maciejgrosz/engineer-thesis/engineer-thesis.pdf

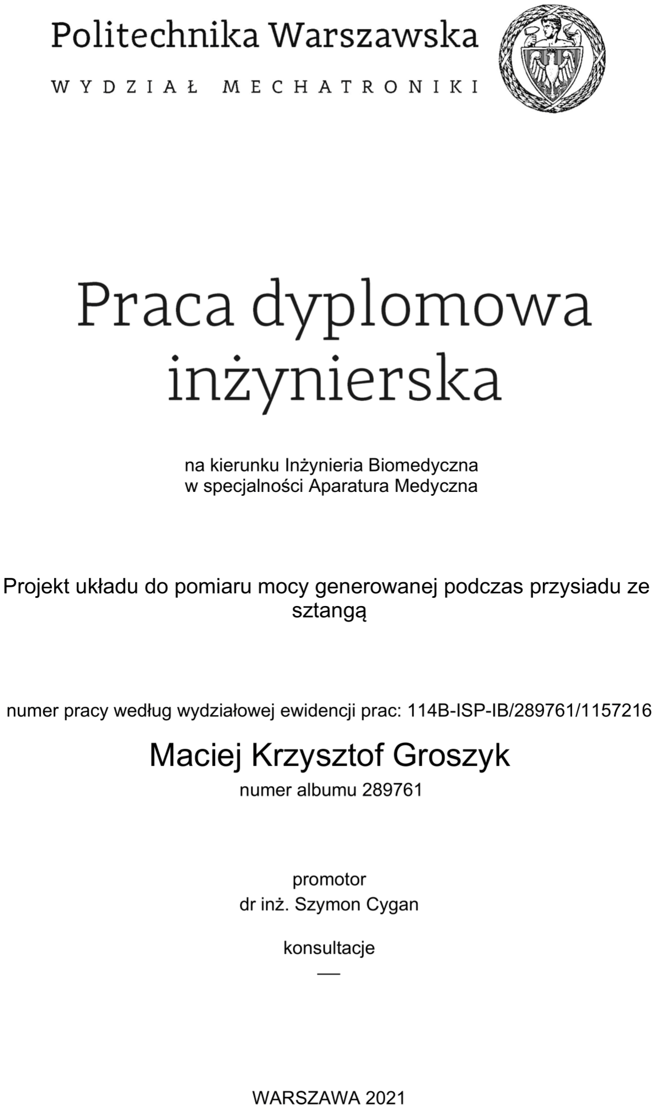
[picture p1: page 1]

1

2

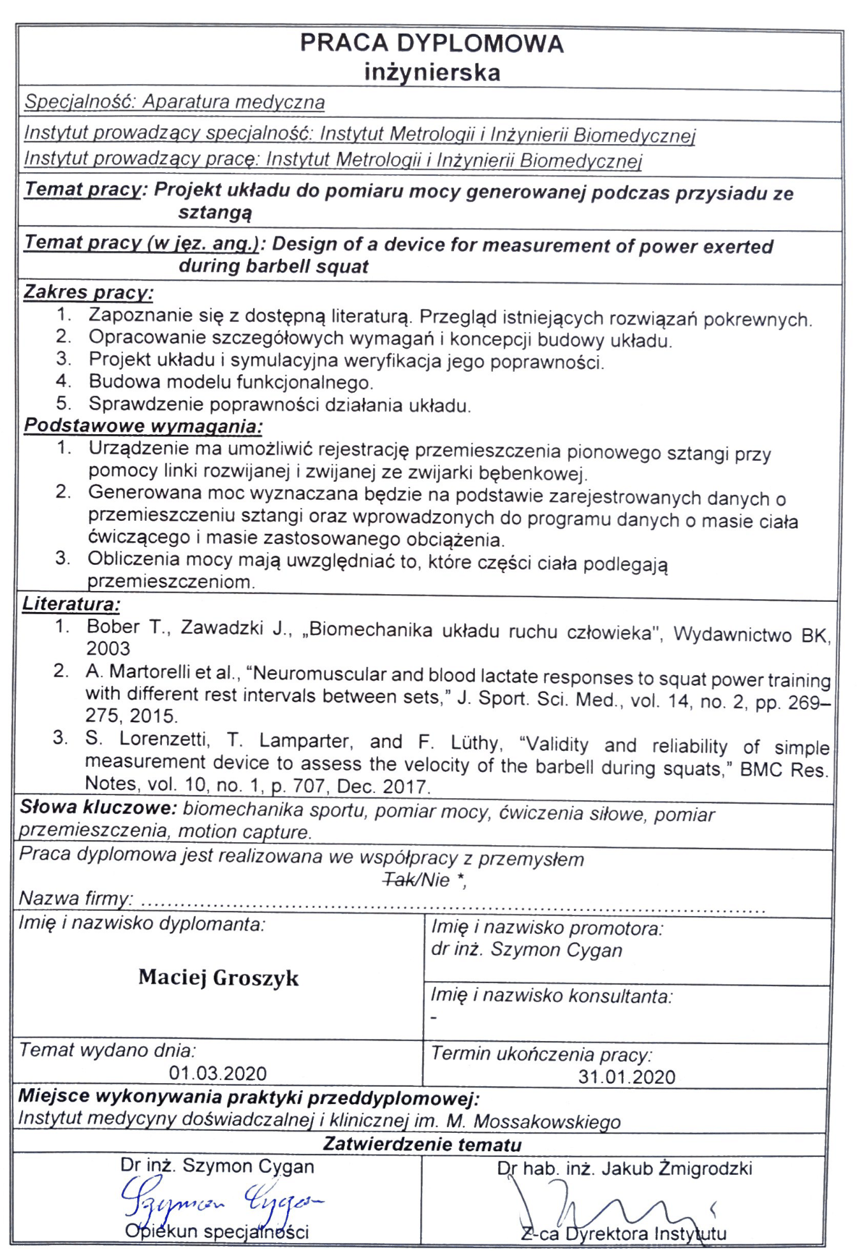
[picture p2: page 3]

3

4

5

Projekt układu do pomiaru mocy generowanej podczas przysiadu ze sztangą

Słowa kluczowe: biomechanika sportu, pomiar mocy, ćwiczenia siłowe, pomiar przemieszczenia

| Streszczenie

Przedmiotem pracy dyplomowej jest projekt układu pomiaru mocy generowanej podczas przysiadu ze sztangą z aplikacją umożliwiającą wizualizację pomiarów w postaci wykresów.

W pierwszym rozdziale został przedstawiony cel pracy oraz założenia jakie należało spełnić podczas projektowania urządzenia i aplikacji. We wstępie został również umieszczony plan pracy, w którym krótko opisano kolejne etapy pracy dyplomowej.

W kolejnym rozdziale przytoczono przykładowe zastosowania urządzenia do pomiaru mocy, a także opis poprawnie wykonanego ćwiczenia tzn. przysiadu ze sztangą, dla którego zaprojektowane są obliczenia i urządzenie. Następnie zaprezentowane zostały przykładowe rozwiązania pomiaru mocy z użyciem enkodera dostępne na rynku.

Główną częścią pracy dyplomowej jest realizacja projektu, której opis stanowi rozdział trzeci. Opisano w nim podstawową zasadę działania urządzenia, a także postawiono wymagania i założenia dotyczące fizycznego modelu konstrukcji. Następnie wymieniono główne elementy wchodzące w skład projektu. Główną częścią urządzenia jest enkoder obrotowy, którego zasada działania została opisana w podrozdziale 3.4.1. Zostały w nim przedstawione różne typy enkoderów, oraz dokładna budowa optycznego enkodera obrotowego, który został wybrany do projektu. W kolejnym punkcie dokładnie opisano użyty model enkodera w projekcie. W następnym etapie pracy uzasadniono wybór mikrokontrolera na platformie Arduino Uno, oraz przedstawiono zdjęcie opisujące płytkę. W kolejnych podrozdziałach została opisana konstrukcja urządzenia oraz sposób działania układu. Wypisane zostały gotowe elementy handlowe oraz przedstawiono cały proces wytwarzania pozostałych elementów do modelu urządzenia. Na końcu został pokazany poprawny schemat podłączenia enkodera do płytki Arduino Uno.

Czwartą częścią pracy są obliczenia wykorzystane w przeliczeniu odczytów z enkodera na moc wytworzoną przez ćwiczącego.

W piątym rozdziale został opisany schemat działania oprogramowania urządzenia. Opisany został zarówno kod zaimplementowany do mikrokontrolera arduino, jak i schemat działania aplikacji komputerowej umożliwiającej łatwe korzystanie z urządzenia przez użytkownika.

W kolejnym rozdziale przedstawiono krok po kroku jak należy poprawnie korzystać z zaprojektowanego układu oraz aplikacji, aby uzyskać prawidłowe wyniki bez zakłóceń i szumów.

W siódmym rozdziale przedstawiono proces kalibracji urządzenia, a także wyniki uzyskane za pomocą rozwiązania komercyjnego oraz pracy dyplomowej Julii Król. A także uzasadniono różnice w uzyskanych rezultatach.

6

Praca została zakończona oceną realizacji urządzenia oraz aplikacji. W końcowym rozdziale zawarto również pomysły na dalszy rozwój urządzenia.

7

Design of a device for measurment of power exerted during barbell squat

Key words: motion capture, sports biomechanics, power measurments, force measurments

Abstract

The subject of this thesis is the design of a system meant to measure the power generated during a barbell squat with an application to visualize the measurements in the form of graphs.

The first chapter purpose of the work and the assumptions that had to be fulfilled during the design of the device and the application are presented. In the introduction there is also a plan of work, which briefly describes the next stages of the thesis.

In the next chapter commercial examples of power measurement device are given, along with a description of a correctly performed exercise, i.e. a squat with a barbell, for which the calculations and the device are designed. Next, examples of power measurement solutions with an encoder available on the market are presented.

The main part of this thesis is the implementation of the project, which is described in the third chapter. The description consists of the basic principle of operation of the device as well as the set of requirements and assumptions for the physical model of the design. Then the main components of the project are listed. The main part of the device is the rotary encoder, whose working principle is described in subsection 3.4.1. The different types of encoders are presented there, as well as the exact construction of the optical rotary encoder that was chosen for the project.

The next section describes in detail the encoder model used in the project. The next section describes in detail the encoder model used in the project, while the next point justifies the choice of the microcontroller on the Arduino Uno platform, and presents a photo describing the board. In the following subsections the construction of the device and the way the circuit works are described. Ready-to-use commercial components are listed and the whole process of manufacturing other components for the device model is presented. At the end , the correct scheme of connecting the encoder to the Arduino Uno board is shown.

The fourth part of the work is the calculations used in converting the readings from the encoder to the power generated by the user.

The fifth section describes the software scheme of the device. The code implemented into the Arduino microcontroller and the operating scheme of the

8

computer application that allows easy use of the device by the user are presented.

The next chapter shows step by step how to use the designed circuit and application correctly to get the right results without noise and interference.

The seventh chapter presents calibration process along with the results obtained using a commercial solution and Julia Król's engineer thesis. The difference in the subsequent results is discussed.

The paper is concluded with the evaluation of the implementation of both the device and the application, as well as possible ideas for further development of the device.

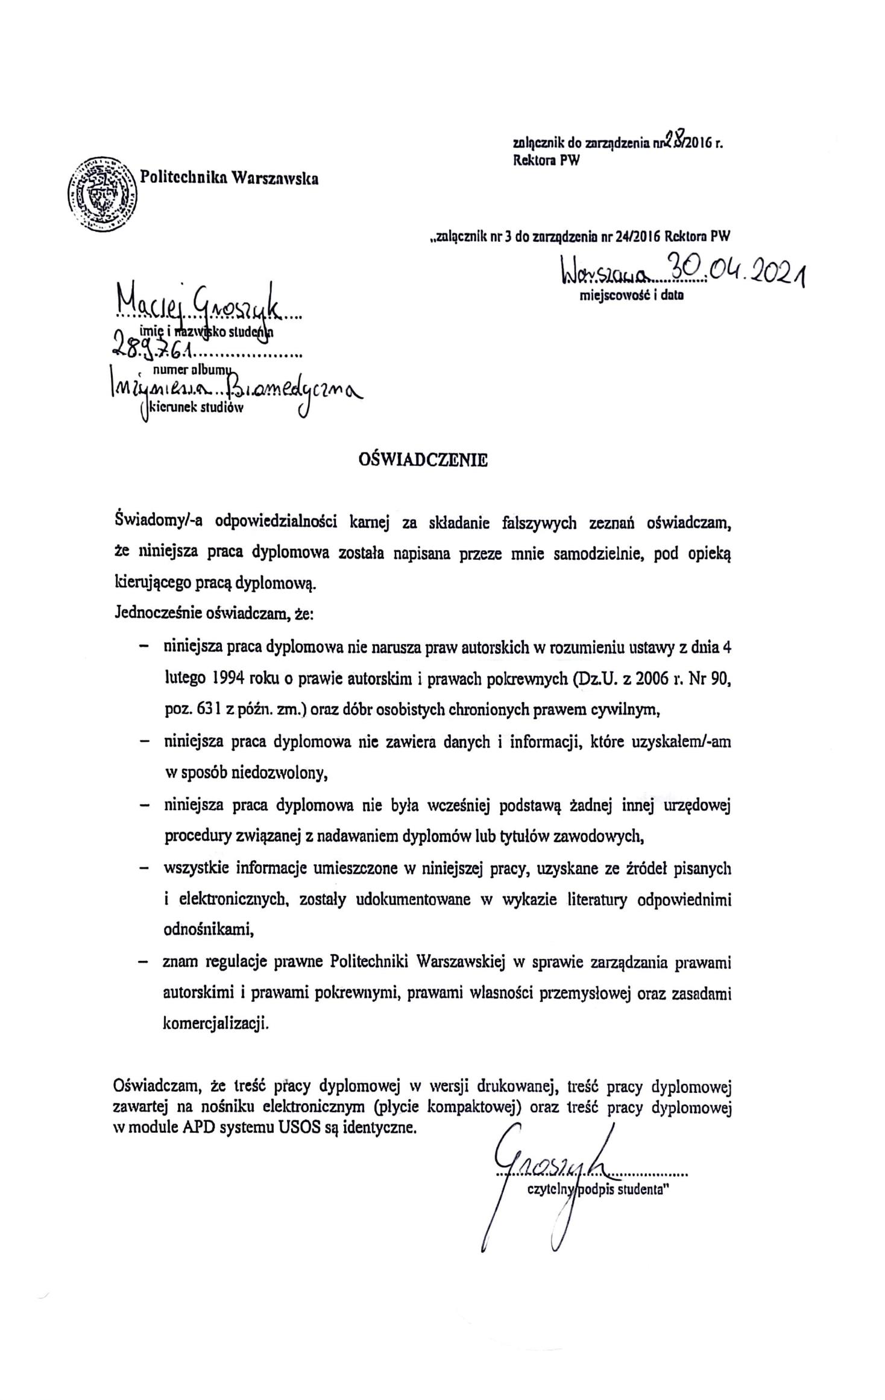
[picture p3: page 9]

9

10

11

Pragnę wyrazić moją wdzięczność trenerowi mgr Michałowi Ficoniowi za umożliwienie mi przeprowadzenia testów wykonanego urządzenia, konsultacje i pomoc w przeprowadzeniu pomiarów, bez których nie miałbym możliwości dodatkowego wzbogacenia swojego urządzenia.

12

13

## Spis treści

14

7.2. Porównanie wyników z urządzeniem komercyjnym firmy MuscleLab ...... 50

15

### 1. Wstęp

### 1.1. Cel i motywacja pracy

Celem pracy jest zaprojektowanie i wykonanie modelu elektronicznego układu do pomiaru mocy generowanej podczas przysiadu ze sztangą. Urządzenie to ma umożliwiać rejestrację przemieszczenia pionowego sztangi podczas ćwiczenia siłowego w postaci przysiadu. Składać się ono będzie z linki mocowanej do sztangi, sprężynowej zwijarki bębenkowej, enkodera obrotowego i układu elektronicznego przetwarzającego sygnał z enkodera do postaci cyfrowej. Następnie sygnał ten będzie przesyłany do komputera, gdzie w oparciu o dane o masie ciała ćwiczącego i masie sztangi wyznaczana będzie moc generowana podczas poszczególnych powtórzeń ćwiczenia.

### 1.2. Założenia pracy

Głównym założeniem pracy jest wykonanie modelu urządzenia do pomiaru mocy, który będzie o wiele tańszy od gotowych rozwiązań komercyjnych dostępnych na rynku. Koszt urządzenia opartego na technologii enkodera obrotowego to obecnie ponad 1000$ [1]. Kolejnym kluczowym założeniem jest uzyskanie przybliżonych i
dość | dokładnych | wartości | pomiaru | mocy | podczas | przysiadu | ze
sztangą, porównywalnych do wyników pomiaru mocy innych dostępnych urządzeń.

Podczas projektowania urządzenia do pomiaru mocy z użyciem enkodera obrotowego przyjęto następujące założenia:

- Niski koszt produkcji
- Prosta i niezawodna konstrukcja
- Łatwa obsługa urządzenia
- Dane pomiarowe z urządzenia będą przekazywane do komputera w celu dalszej ich analizy
- Aplikacja komputerowa będzie przekształcać dane zebrane przez układ pomiarowy na moc
- Możliwość porównania wyników z innymi sposobami pomiaru mocy

### 1.3. Plan pracy

Praca podzielona została na 8 części. Pierwszy rozdział to krótki wstęp i przedstawienie założeń projektowych. Drugi etap to wprowadzenie, które zawiera
wyjaśnienie | w | jakich | sytuacjach | urządzenie | do | pomiaru | mocy | jest
wykorzystywane, opis ćwiczenia wykorzystanego do pomiaru mocy i przykłady komercyjnych urządzeń do pomiaru mocy. W trzecim rozdziale została opisana warstwa sprzętowa dobrana do wykonania stanowiska pomiarowego. W czwartym rozdziale przedstawione zostało wykorzystane oprogramowanie do stworzenia aplikacji, natomiast w piątym rozdziale opisano realizacje projektu.

16

W tym etapie pracy zobrazowany został schemat działania urządzenia, schemat połączenia poszczególnych elementów oraz schemat działania aplikacji. W rozdziale szóstym przedstawiona została instrukcja obsługi urządzenia. Rozdział siódmy zawiera testy pomiarowe przeprowadzone nad gotowym urządzeniem. W rozdziale ósmym przedstawione zostały uwagi końcowe razem z oceną realizacji i możliwościami rozwoju urządzenia w przyszłości.

17

### 2. Wprowadzenie

### 2.1. Zastosowania urządzenia do pomiaru mocy

W obecnych czasach istotnym czynnikiem, który wpływa na dynamiczniejszy rozwój sportowców jest technologia. Dzięki współczesnej nauce wszystkie dyscypliny sportowe wprowadziły w swoje treningi urządzenia, które pozwalają na szybszy wzrost umiejętności i efektywności zawodnika [2].

Przykładowo podczas treningów szachowych komputery pozwalają przeprowadzić analizę partii nawet ze 100% dokładnością. Dzieje się tak za sprawą nowoczesnych silników szachowych. Dzięki temu przeciętni profesjonalni szachiści XXI wieku są w stanie grać o wiele lepiej niż historyczni mistrzowie świata [3].

Tenis to kolejna dyscyplina sportowa, która na przestrzeni lat znacząco rozwinęła się dzięki technologii. Jeszcze około 30 lat temu ludzie nie wyobrażali sobie, że tenisiści będą potrafili rozgrywać mecze trwające ponad 5 godzin. Takie wyniki są możliwe tylko i wyłącznie dzięki świetnemu przygotowaniu fizycznemu zawodników i odpowiedniemu treningowi. Obecnie istnieją maszyny, które są w stanie zastąpić partnera w treningu. Odpowiednie maszyny do podawania piłek tenisowych są w stanie wyrzucać piłki z prędkością nawet do 150 km/h. Możliwe są ustawienia konkretnych rotacji na piłkach, a także różnych kątów lotów piłek. Między innymi takie urządzenia spowodowały wejście tego sportu na kolejny poziom [4].

Nie da się ukryć, że najbardziej eksploatowanymi mięśniami w wielu dyscyplinach sportowych są mięśnie nóg. Odgrywają one znaczącą rolę dla zawodników piłki nożnej, siatkówki czy koszykówki. Dobrze ułożony trening dla każdego sportowca to podstawa udanej kariery i jego rozwoju w wybranej dziedzinie.

Jednym z urządzeń pomagającym trenerom w dostosowaniu odpowiedniego treningu do jak najlepszego rozwoju zawodnika jest urządzenie do pomiaru mocy. Pozwala ono na dopasowanie obciążeń podczas mikro, makro i mezo cykli treningowych w taki sposób, aby jak najefektywniej rozwijać moc poszczególnych partii mięśni. Dobrze zaprogramowane przygotowanie motoryczne zapobiega kontuzjom, wzmacnia ciało, a także poprawia ekonomię ruchu i pozwala osiągać maksimum możliwości fizycznych sportowca. Układ pomiarowy pomaga również w doborze 1RM czyli maksymalnego ciężaru, z którym sportowiec jest w stanie wykonać tylko jedno powtórzenie. Jest to szczególnie ważne dla osób po kontuzjach bądź dla osób starszych, dla których doświadczalne wyznaczanie 1RM może skończyć się kolejną kontuzją.

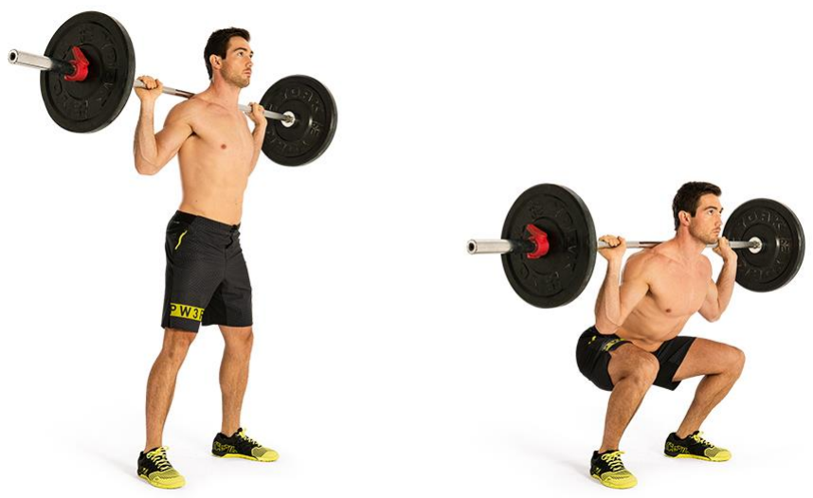
[picture p4: figure]

18

### 2.2. Opis ćwiczenia wykorzystywanego do pomiaru mocy

Ćwiczeniem wybranym do pomiaru mocy jest przysiad ze sztangą (rysunek 1). Jest to najpopularniejsze oraz jedno z najważniejszych ćwiczeń do budowy mocy nóg [5].

Aby poprawnie wykonać przysiad należy stanąć w pozycji wyprostowanej. Chwytamy sztangę szerokim rozstawem rąk w okolicach talerzy obciążających. Następnie przechodzimy pod nią tak, aby sztanga znalazła się z tyłu na naszych barkach, przy czym ściągamy łokcie do tyłu. Stajemy na całych stopach, palce ustawiamy lekko na zewnątrz. Rozstaw stóp nieco szerszy od szerokości bioder. W pozycji końcowej należy pamiętać, aby uda były równolegle do podłogi, a kolana były skierowane na zewnątrz i nie przekraczały linii palców stopy. Bardzo ważne, aby podczas przysiadu utrzymywać proste plecy. Garbienie się przy przysiadzie z
obciążeniem | grozi | powstaniem | przepukliny | jądra | miażdżystego | krążka
międzykręgowego lub innych, równie groźnych, urazów w obrębie kręgosłupa. Ze
względu | bezpieczeństwa | przy | dużych | ciężarach | musimy | używać | pasa
treningowego [6].

Mięśnie głównie zaangażowane w przysiad to: mięśnie czworogłowe i dwugłowe uda, mięśnie bioder, pośladków i dolnego grzbietu.

Rysunek 1: przysiad ze sztangą [7]

19

### 2.3. Komercyjne urządzenia do pomiaru mocy

a) Urządzenie GymAware

Jednym z komercyjnych urządzeń dostępnych na rynku do mierzenia mocy jest urządzenie firmy GymAware (rysunek 2). Jego zasada działania oparta została na optycznym enkoderze obrotowym. Urządzenie tego typu zostało opisane w kilku artykułach [8].

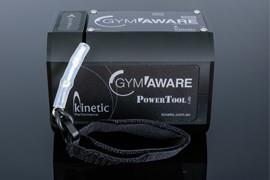
[picture p5: figure]

Rysunek 2: Urządzenie do pomiaru mocy GymAware [8]

20

b) Urządzenie FitroDyne

Drugim popularnym dystrybutorem urządzeń opartych na enkoderze jest firma Fitronic ze Słowacji. Urządzenie FitroDyne (rysunek 3) jest dużo tańszym rozwiązaniem od kompleksowego urządzenia Gymaware. Słowackie urządzenie nie posiada wielu udogodnień, a jego software jest archaiczny. Natomiast budowa urządzenia jest prosta i pozwala w łatwy sposób zrozumieć ideę funkcjonowania tego typu urządzeń.

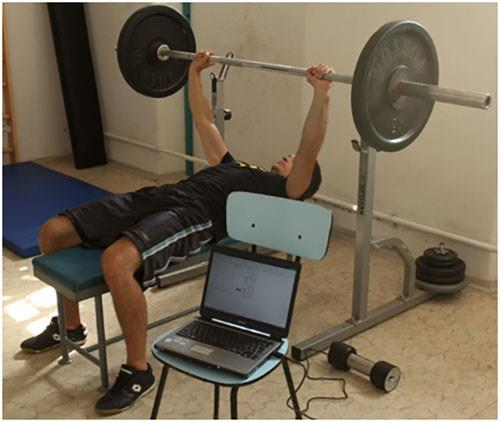
[picture p6: figure]

Rysunek 3: Urządzenie do pomiaru mocy FitroDyne [9]

Zasada działania | urządzenia opartego na | enkoderze | obrotowym | została
przedstawiona w artykule [10]. Urządzenie to zostało zaprojektowane tak, aby zliczenia odbywały się co 1 milisekundę. Kolejną wartościową informacją była
dokładność pobieranych zliczeń. | Sygnały | trafiają z | tego | urządzenia | do
mikroprocesora co 3 | mm wysunięcia linki.

21

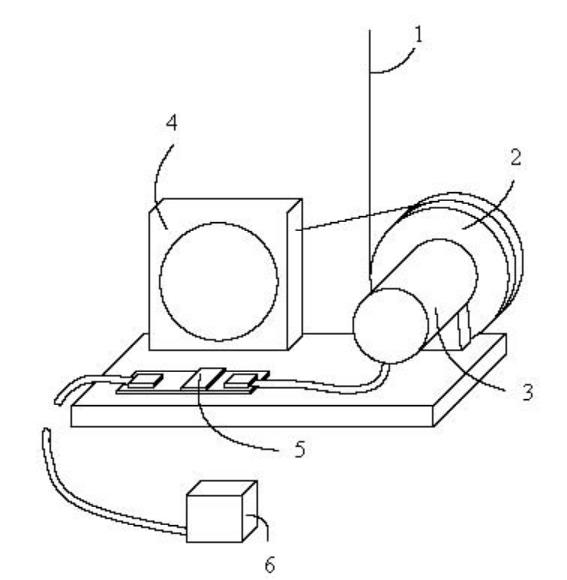
[picture p7: figure]

Rysunek 4: Schemat urządzenia do pomiaru mocy [10]

1. Linka
2. Krążek
3. Enkoder obrotowy
4. Sprężynowa zwijarka bębenkowa
5. Układ z mikroprocesorem
6. Nadajnik-odbiornik podczerwieni

W artykule [11] natomiast bardziej szczegółowo została opisana zasada działania enkodera obrotowego oraz czynniki, które należy wziąć pod uwagę podczas wyboru przetwornika do zbudowania układu do pomiaru mocy.

W publikacji [11] zalecaną minimalną wartością rozdzielczości enkodera jest 0,1% w pełnej skali wysunięcia linki. Przy założeniu, że ćwiczeniem doświadczalnym jest przysiad ze sztangą na plecach, pełna skala wysunięcia linki oscyluje w granicach 1 m. Zatem oszacowaną minimalną wartością rozdzielczości enkodera jest 1 mm. Co ciekawe wartość ta różni się od założonej wartości w poprzednim artykule. Może ona wynikać z innych wielkości pełnej skali wysunięcia linki (przy przysiadzie ze sztangą na plecach wartość będzie mniejsza od wysunięcia linki przy podnoszeniu sztangi nad głowę), a także z faktu, że taka dokładność całkowicie znika pod tym jak bardzo niepowtarzalny jest konkretny przysiad. Również wartości około 1 mm mają znikomy wpływ przy generowanej mocy rzędu 1000 W.

Kolejnym czynnikiem omawianym w artykule jest czas próbkowania, autorzy sugerują, że wymaganą częstotliwość zliczeń to 500-1000 Hz, co w przeliczeniu pokrywa się z poprzednim artykułem [11].

22

23

### 3. Realizacja projektu

### 3.1. Zasada działania urządzenia

Zadaniem urządzenia jest pomiar/rejestracja pionowego przemieszczenia sztangi w czasie i przekazanie tej informacji do programu. Na tej podstawie wyznaczane są parametry kinematyczne – przemieszczenie, prędkość i przyspieszenie (s(t), v(t) i a(t)). Siły wyliczane są w programie na podstawie wprowadzonych danych takich jak masa oraz wzrost ćwiczącego, masa obciążenia. Ostatecznie moc wyznaczana jest z podstawowego wzoru:

P =

dWlift(t)
dt

gdzie:

Wlift- praca chwilowa wykonana w czasie dt

t – czas

### 3.2. Założenia konstrukcji

- Spełnienie koncepcji struktury kinetycznej, tj. translacyjny ruch sztangi wywołuje jednoznacznie określony ruch obrotowy wału enkodera
- Stabilność mechaniczna urządzenia pomiarowego
- | Uzyskanie | wysokiej jakości | odczytów, | redukując | błędy wynikające | z
nieprawidłowej | integracji | handlowego | urządzenia | pomiarowego | z
zaprojektowanym urządzeniem (np. poślizg koła zamachowego na wale enkodera, powstałego w wyniku szarpnięcia sztangą)
- Przy cyklicznych ruchach sztangi (góra – dół) zapewnienie swobodnego powrotu wskazania kąta do pozycji początkowej
- Wał enkodera, będący oddzielnym urządzeniem pomiarowym, nie powinien być obciążony jakimikolwiek momentami gnącymi lub siłami poprzecznymi, przenoszonymi przez konstrukcję
- Niski koszt produkcji, z wykorzystaniem gotowych elementów handlowych oraz powszechnych technik wytwarzania
- Łatwy montaż i konserwacja urządzenia

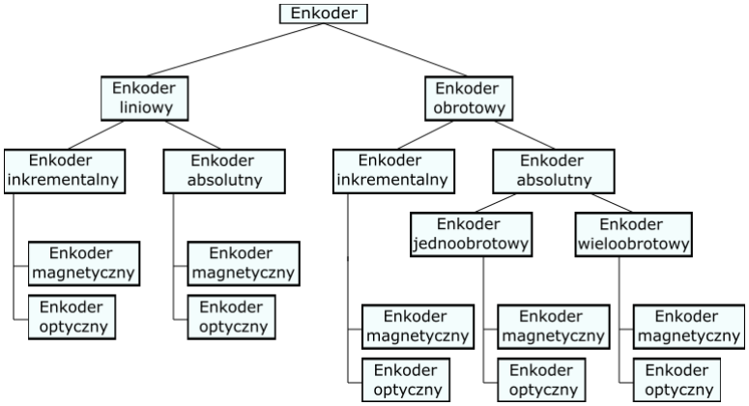
[picture p8: figure]

24

### 3.3. Warstwa sprzętowa

Do realizacji urządzenia do pomiaru mocy podczas przysiadu ze sztangą zastały wykorzystane:

- Układ enkoder obrotowy - koło zamachowe
- Urządzenie złożone ze sprężynowej zwijarki bębenkowej wraz z linką mocowaną do sztangi
- Układ elektroniczny przetwarzający sygnał z enkodera do postaci cyfrowej
- Obudowa urządzenia

### 3.4. Dobór odpowiedniego enkodera

### 3.4.1. Ogólna charakterystyka enkoderów

Enkodery to przetworniki do ilościowego określania ruchu obrotowego lub liniowego i wyrażania go w postaci impulsów elektrycznych [12].

Rysunek 5: Podział enkoderów

Można je podzielić na enkodery obrotowe oraz enkodery liniowe. Różnią się one zastosowaniem przetwornika w danych urządzeniach. Enkodery obrotowe służą do pomiaru położenia kątowego obiektu, natomiast enkodery liniowe mierzą jego przemieszczenie.

Zarówno enkodery obrotowe jak i liniowe dzielą się dalej na enkodery absolutne
i enkodery inkrementalne. | Główną | ich | różnicą | jest | sposób | pomiaru

25

ruchu. Enkodery absolutne generują sygnał wyjściowy w postaci analogowej. Jest to możliwe poprzez wyposażenie tarczy enkodera w unikatowy kod dla każdej pozycji, w wyniku czego każde położenie kątowe wału ma przypisaną wartość kodową na wyjściu. Dzięki sygnałowi kodowanemu enkodery absolutne są w stanie zapamiętywać aktualną pozycję nie tylko w momencie, gdy są one włączone, ale również po odłączeniu zasilania. Każdej pozycji kątowej w tym układzie odpowiada konkretna wartość kodowa. Nawet zmiana pozycji osi przetwornika przy braku jego zasilania pozwala zmierzyć dokładną pozycję od razu po ponownym jego zasileniu.
Natomiast enkodery inkrementalne | nie | generują położenia | bezwzględnego.
Oznacza to, że położenie wału określane jest przez zliczanie impulsów elektrycznych. W przypadku odłączenia zasilania, wartość położenia będzie naliczana od zera, to znaczy od miejsca, w którym nastąpiło jego zatrzymanie [13].

Najczęściej używanym enkoderem w urządzeniach do pomiaru mocy generowanej podczas przysiadu z obciążeniem jest inkrementalny obrotowy enkoder optyczny. Wykorzystuje on zjawisko fotoelektryczne.

Optyczny enkoder obrotowy zbudowany jest z:

- Tarczy obrotowej, która posiada nacięte szczeliny lub z tarczy przeźroczystej z nadrukowanymi przesłonami
- Diody, na przykład podczerwonej znajdującej się po jednej stronie tarczy
- Elementu światłoczułego, na przykład fotodiody, znajdującej się po drugiej stronie tarczy

Wiązka światła przechodzi przez obracającą się tarczę, w wyniku czego do elementów światłoczułych sygnał trafia w postaci impulsów, które natomiast powodują generowanie impulsowego napięcia. Następnie sygnał wyjściowy przetwarzany jest na drogę kątową bądź ciąg impulsów tarczy.

26

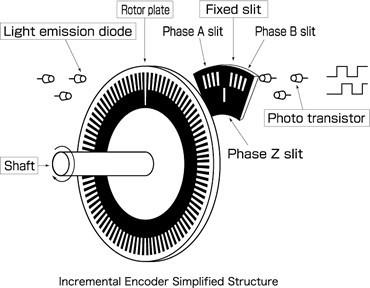
[picture p9: figure]

Rysunek 6: Schemat działania optycznego enkodera obrotowego [14]

Shaft - wał enkodera
Light emission diode – dioda emitująca światło Rotor plate - płyta rotora
Phase A slit – szczelina fazy A
Phase B slit – szczelina fazy B
Phase Z slit – szczelita fazy Z Fixed slit – stała szczelina
Photo transistor - fototranzystor

Inkrementalny obrotowy enkoder optyczny posiada dwa sygnały wyjściowe A i B przesunięte względem siebie o 90°. Służą one do określania kierunku obrotu wału enkodera. Podczas obrotu wału w prawo, wysyłany jest impuls A przed impulsem
B. Natomiast podczas obrotu wału w lewo, wysyłany jest impuls B przed impulsem
A. Enkodery inkrementalne można również zastosować do określania prędkości ruchu. Położenie względem punktu początkowego można wyznaczyć, zliczając liczbę impulsów, natomiast prędkość można obliczyć, dzieląc liczbę impulsów przez zmierzony przedział czasu.

### 3.4.2 Enkoder zastosowany w projekcie

Najważniejszą cechą enkodera w urządzeniach do pomiaru mocy generowanej podczas przysiadu z obciążeniem jest rozdzielczość. Określa ona dokładność z jaką enkoder mierzy przemieszczenie kątowe wału. Przemieszczenie sztangi w ruchu pionowym podczas przysiadu dla mężczyzny o wzroście 180 cm to
około 80 cm. Dla | bezpieczeństwa | przyjąłem | 1 m | jako maksymalne pełne
wyciągnięcie linki. Po przeliczeniu zliczenia powinny być zbierane co 1 mm.

27

Na polskim rynku w przystępnej cenie dostępnych jest tylko kilka enkoderów optycznych o różnej rozdzielczości do wyboru. Z powodu braku dużego wyboru został wybrany obrotowy enkoder optyczny o rozdzielczości 400 zliczeń na obrót dla każdej fazy, co daje możliwość uzyskania 1600 impulsów na obrót z wykorzystaniem obu sygnałów. Model zakupionego enkodera to DFRobot 400P/R. Enkoder ten generuje dwufazowy, prostokątny sygnał impulsowy AB, przez obrót tarczą z transoptorem, a jego maksymalna prędkość to 5000 obrotów na minutę. Dodatkowym atutem tego enkodera jest kompatybilność z mikrokontrolerem Arduino.

Do prawidłowego działania enkodera potrzebny jest również rezystor podciągający z powodu tego, że na wyjściu układu znajduje się tranzystor NPN w konfiguracji otwartego kolektora. Z racji tego, że Arduino jest wyposażone w rezystor podciągający, nie ma potrzeby używania zewnętrznego rezystora.

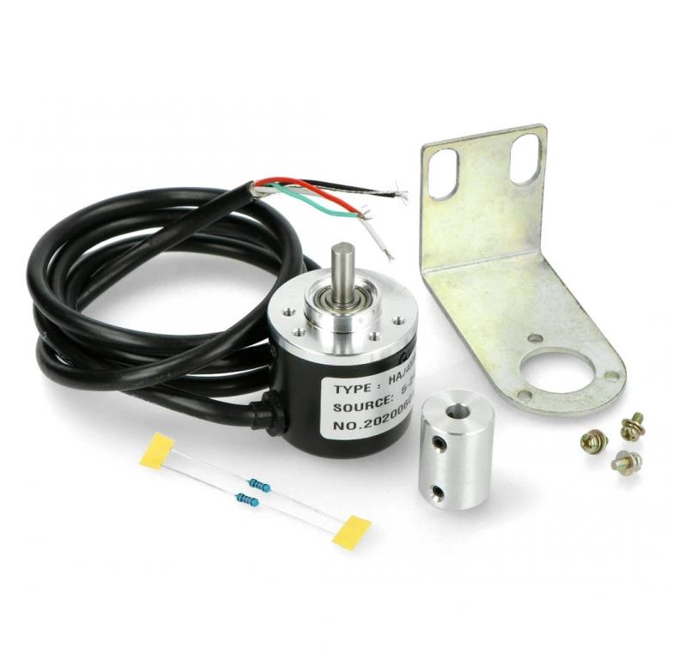
[picture p10: figure]

Rysunek 7: Zestaw enkodera DFRobot 400P/R [15]

Aby | spełnić | stawiane | założenia | projektu, należało | również | dobrać
odpowiedni obwód koła zamachowego. W przypadku wymaganej dokładności
pomiaru | 1 mm | i | rozdzielczości enkodera 400 | PPR, | maksymalny | obwód
koła powinien | wynosić 400 mm. W | przypadku | urządzenia | opisywanego | w
niniejszej pracy została przyjęta średnica koła równa 125 mm, obwód równy około 392,5 mm. Koło zamachowe składa się z trzech wyciętych kół ze sklejki. Dwa zewnętrzne o grubości 3 mm i średnicy 137 mm i jedno w środku o grubości 6 mm i średnicy 125 mm. Średnica otworu jest równa 6 mm.

28

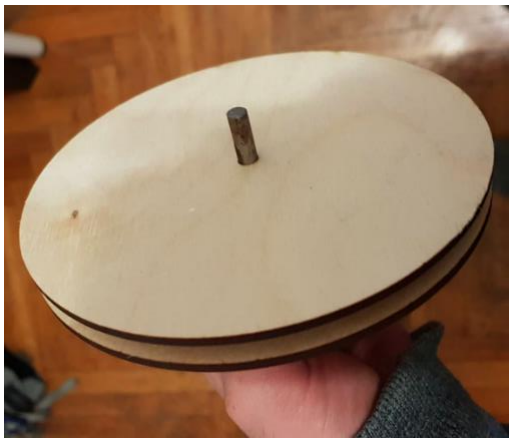
[picture p11: figure]

Rysunek 8: Koło zamachowe

### 3.5. Mikrokontroler

W projekcie użyto mikrokontroler Arduino Uno. Został on wybrany ze względu na:

- Przyjazne środowisko programistyczne Arduino IDE
- Prostą składnia języka programowania
- Stosunkowo niską cenę
- Bardzo duże wsparcie społeczności
- Kompatybilność enkodera z Arduino zaznaczona przez producenta w opisie urządzenia

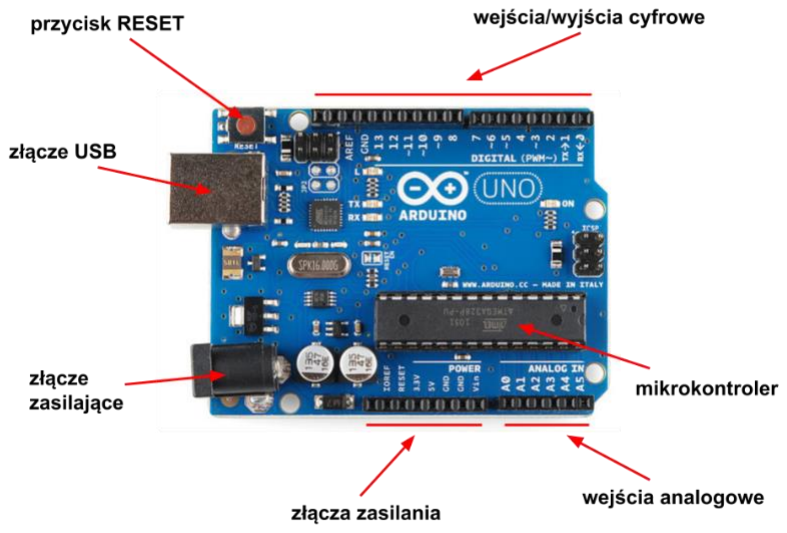
[picture p12: figure]

Rysunek 9: Płytka Arduino UNO [16]

29

### 3.6. Konstrukcja

Składa się ona z trzech głównych części:

- Deska podtrzymującą całą konstrukcję
- Elementy podtrzymujące i usztywniające całe urządzenie
- Elementy scalające enkoder i koło zamachowe

Całość została zaprojektowana przy użyciu dostępnego oprogramowania CAD Autodesk Inventor. Rysunek techniczny został zamieszczony w załączniku nr 1

Linka, owijająca koło zamachowe wywołuje ruch obrotowy koła zamachowego oraz wału enkodera zgodnie z powszechną zależnością geometryczną:

xsztangi = 2 ∙ π ∙ rkoła ∗ φkątobrotuwału

Naciągnięta linka, nawinięta kilkukrotnie na kole zamachowym, momentem działającym w przeciwnym kierunku do wychylenia:

F = kx

zwiększa napór i zwiększa tarcie linki o koło zamachowe, które powoduje ruch układu.

Te rozwiązanie niesie ze sobą jednakże ryzyko powstania błędów wskazania kąta, wynikających z poślizgu, podczas ewentualnego szarpnięcia. Jednak sam charakter ćwiczenia powoduje, że istotne szarpnięcia nie będą występowały. Duża masa
podlegająca | przemieszczeniu | posiada | dużą | bezwładność, | zatem | duże
przyspieszenie nie występuje. Należy również zaznaczyć, że w teorii może występować histereza przemieszczenia względem kąta w całym zakresie pomiarowym (ruch sztangi góra-dół). Szybki ruch w dół – linka nie nadąża z danym momentem sprężyny z odpowiednim naciągnięciem linki, nie „przykleja” się do koła zamachowego.

30

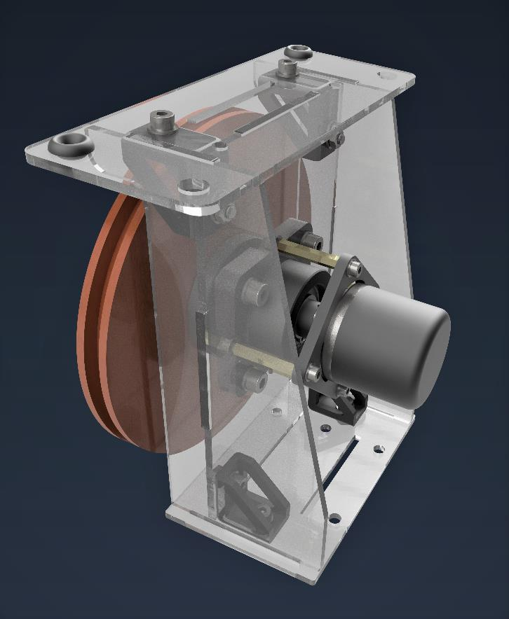
[picture p13: figure]

Rysunek 10: Projekt całego urządzenia

### 3.7. Elementy handlowe

W urządzeniu oprócz enkodera i mikrokontrolera, elementy handlowe stanowią:

- Łożyska
- Normalia
- Dystanse

Mając na uwadze niski koszt projektu oraz spełnienie założeń konstrukcyjnych (powrót wskazania do pozycji zerowej) wykorzystano smycz z wbudowanym mechanizmem powrotnym cięgna. Podczas ćwiczenia koniec linki przymocowany zostanie do sztangi.

Linka musi mieć dobrze dobraną długość, a także kluczowym wymaganiem jest to aby samoistnie i bezproblemowo wracała do położenia początkowego. Zadaniem linki jest śledzenie położenia sztangi, aby następnie za pomocą koła zamachowego zamienić przemieszczenia liniowe na kątowe. Kolejnym istotnym parametrem linki jest grubość, ponieważ musi być ona zawinięta na kole zamachowym. Z powodu tylu ograniczeń bardzo ciężko znaleźć profesjonalne urządzenie. Jedynym

31

gotowym rozwiązaniem okazała się smycz firmy Flexi dla psa. Wybrano smycz w najmniejszym możliwym rozmiarze, o długości 3 m.

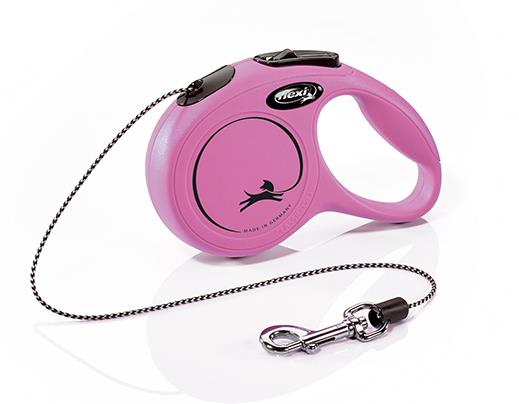
[picture p14: figure]

Rysunek 11: Smycz Flexi 3m [17]

### 3.8. Techniki wytwarzania elementów konstrukcyjnych

Do wykonania elementów podtrzymujących zostało wykorzystane tworzywo sztuczne PMMA. Największą przewagą szkła akrylowego nad innymi materiałami jest łatwość obróbki oraz dostępność i cena. Pierwotnie szkielet stanowiska miał zostać zbudowany ze stali konstrukcyjnej o grubości co najmniej 2 mm. Niestety koszt cięcia blachy wraz z gięciem oraz gratowaniem znacząco zwiększał cenę wykonania całego urządzenia.

Elementy zostały wycięte na laserze ze szkła akrylowego 25x25 cm o grubości 3 mm. Elementy po złożeniu wymagały dodatkowych mocowań. Dla dodatkowej stabilizacji zostały wykorzystane kątowniki, wydrukowane na drukarce 3D z materiału ABS. Szkielet został przykręcony do drewnianej deski, która dodatkowo zwiększyła ciężar modelu.

32

### 3.9. Schemat połączenia enkodera z Arduino

Enkoder został połączony z mikrokontrolerem Arduino za pomocą schematu przedstawionego na rysunku 12. Do jego połączenia nie zostały użyte rezystory podciągające ze względu na możliwość użycia wbudowanych rezystorów w Arduino za pomocą trybu INPUT_PULLUP w programie aplikowanym do Arduino. Enkoder posiada cztery wyjścia:

- Białe – odpowiada za zasilanie enkodera, które zostało podpięte do złącza zasilania 5V
- Czarne – zostało podłączone do masy układu
- Czerwone – odpowiada za sygnał A
- Zielone – odpowiada za sygnał B

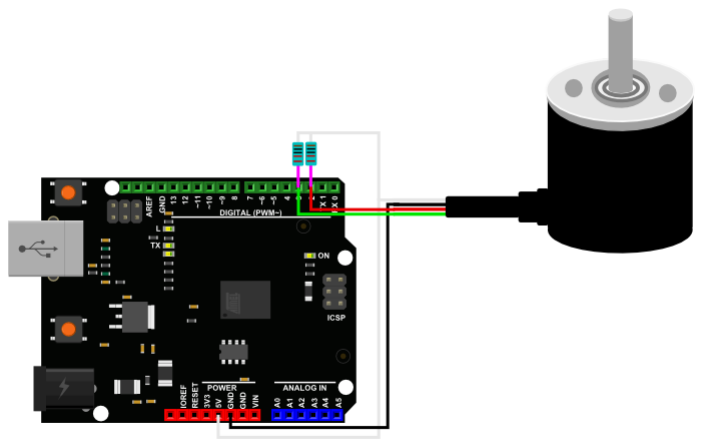
[picture p15: figure]

Rysunek 12: Schemat połączenia enkodera z mikrokontrolerem z dokumentacji producenta [18]

33

### 4. Obliczenia wykorzystane w aplikacji

Jednym z najważniejszych elementów obliczeń, jest poprawne ustalenie masy ciała, która uczestniczy podczas przysiadu. Rysunek 13 przedstawia szkic przysiadu z zaznaczonymi mięśniami biorącymi udział podczas przysiadu ze sztangą.

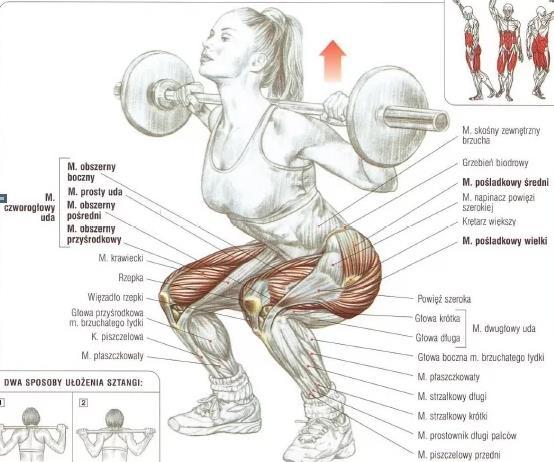
[picture p16: figure]

Rysunek 13: Mięśnie biorące udział podczas ćwiczenia[19]

34

Z powodu specyfikacji ćwiczenia, podczas obliczeń mocy konieczne jest podzielenie modelu ćwiczącego na trzy segmenty:

- Głowa, ręce, tułów i sztanga
- Uda
- Podudzia, piszczele i stopy

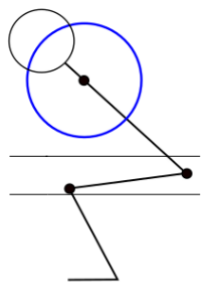
[picture p17: figure]

Rysunek 14: Podział modelu ćwiczącego

Do obliczeń, należy przyjąć całkowitą masę pierwszego segmentu. Drugi segment składa się z części uda, a dokładnie 54.5% masy uda. Jest to spowodowane tym, że środek masy położony jest w 45.5% odległości od stawu biodrowego (tabela 2), a promieniem wodzącym decydującym o wznoszeniu środka ciężkości jest odległość od stanu kolanowego. Natomiast podudzia, piszczele oraz stopy nie biorą w ogóle udziału przy wytwarzaniu mocy przez ćwiczącego. Masy poszczególnych segmentów ciała będą wyliczane za pomocą równań regresji Zatziorsky’ego (tabela 1).

W obliczeniach zostało uwzględnione Fsmycz, czyli stała siła zwijająca smyczy. Niestety smycz nie posiada dokładnie opisanej dokumentacji, w której byłaby podana wartość siły. Z tego powodu, została ona zmierzona doświadczalnie i jest równa 0.15 ∙ g N, gdzie g jest równe przyspieszeniu Ziemskiemu.

35

Część ciała | Równanie regresji
Głowa | 1,296 + 0,0171x1 + 0,0143x2
Górna część tułowia | 8,2144 + 0,1862x1 − 0,0584x2
Środkowa część tułowia | 7,181 + 0,2234x1 − 0,0663x2
Dolna część tułowia | −7,498 + 0,0976x1 + 0,04896x2
Ramię | 0,250 + 0,03012x1 − 0,0027x2
Przedramię | 0,3185 + 0,01445x1 − 0,00114x2
Ręka | −0,1165 + 0,0036x1 + 0,00175x2
Udo | −2,649 + 0,1463x1 + 0,0137x2
Podudzie | −1,592 + 0,0362x1 + 0,0121x2
Stopa | −0,829 + 0,0077x1 + 0,0073x2

Tabela 1: Równania regresji do wyznaczania ciężarów części ciała człowieka według V. N. Zatziorsky’ego [19]

Część ciała | r[%] | Odległość
Głowa | 50,0 | Vertex – SC
Tułów | 44,5 | Suprasternale-SC
Ramię | 45,0 | oś stawu - SC
Przedramię | 42,7 | oś stawu - SC
Ręka | 37,0 | oś stawu - SC
Udo | 45,5 | oś stawu - SC
Podudzie | 40,5 | oś stawu - SC
Stopa | 44,1 | Pternion - SC

Tabela 2: Promienie wodzące (r) środków ciężkości ciała w % ich długości (mierzy się zawsze od bliższego końca) [20]

mgcz = mgł + mtułowia + 2 ∙ mręki

mud = 2 ∙ muda

m = mszt + mgcz + 0.545 ∙ mud

x1– masa całkowita człowieka x2 – wzrost człowieka
mszt – masa sztangi
mgcz – masa górnej części ciała mud – masa ud

36

Równanie dynamiki dla obciążnika:

∑Fy : = −Flift + ma + mg + Fsmycz + S = 0

Równanie dynamiki dla krążka:

∑Mo : − Jε + Sr − MFR − Mspr = 0

MFR, Mspr ≈ 0

MFR, Mspr ≪ S ∙ r − Jε

Stąd:

S = Flift − ma − mg − Fsmycz

−Jε + Flift − ma ∙ r − mg ∙ r − Fsmyczr = 0

r ∙ Flift = Jε + ma ∙ r + mg ∙ r + Fsmyczr

a = εr

ω = φ̇ =

dφ
dt

ε = φ̈=

d

2φ
dt

2

r ∙ Flift = J ∙ φ̈+ mr

2
- φ̈+ mg ∙ r + Fsmyczr = Mlift(φ,φ̇,φ)

̈Wlift = ∫ Flift ∙ r dφ =

∞
∆φ
∫ Mlift(φ, φ̇,φ)

̈dφ ∞
∆φ

= J ∙ φ̈∙ φ + mr

2φ̈φ + mgr ∙ φ + Fsmyczr ∙ φ

Plift(t) =

dWlift(t)
dt =

d
dt[(J + mr

2
)φφ̈+ mgr + Fsmyczr] =

= (J + mr

2
)(φ̇φ⃛ + φ̇φ̈) + mgrφ̇ + Fsmyczrφ̇

Przez charakter ruchu i znaczną masę obciążenia przyjmujemy, że nie występuje szarpnięcie tzn: φ⃛ = 0

Plift(t) = (J + mr

2
)φ̇φ̈+ mgrφ̇ + Fsmyczrφ̇

dφ
dt =

dφ(k ∙ Ts

)
dt =

φ[k ∙ Ts

] − φ[(k − 1) ∙ Ts

]
kTs − (k − 1) ∙ Ts

= φ̇ =

φ(k) − φ(k − 1)
Ts

37

dφ

2
dt =

dφ̇(k ∙ Ts

)
dt =

[φ[k] − φ(k − 1)] − [φ(k − 1) − φ(k − 2)] Ts

2 | = φ̈

=

φ(k) + 2φ(k − 1) + φ(k − 2) Ts

2

W celu prostej implementacji obliczeń do aplikacji, należy dyskretyzować obliczenia:

Przyjmując A = J + mr

2 B = mgr, C = Fsmyczr oraz A, B i C są stałe.

A: [kg ∙ m²
]

B: [kg ∗

m
s

2

]

C: [kg ∗

m
s

2

]

Plift(k) = Aφ̇(k) ∙ φ(k)

̈ + Bφ̇(k) + Cφ̇(k)[W]

38

39

## 5. Oprogramowanie

### 5.1. Schemat działania programu Arduino

Program zastosowany w Arduino został napisany na podstawie przykładowego kodu z dokumentacji Enkodera [18]. Cały kod źródłowy zaimplementowany w płytce Arduino Uno został zamieszczony w załączniku nr 2.

W pierwszej części kodu zostały zdefiniowane zmienne takie jak:

- Numery odpowiednich pinów dla sygnałów wyjściowych enkodera A i B. A_PHASE – pin drugi, B_PHASE – pin trzeci
- Wartości początkowe dla sygnałów A i B. W związku z początkową fazą ćwiczenia, które rozpoczyna się ruchem sztangi w dół wymagane jest przypisanie sygnałowi A wartości 1000. Natomiast wartość sygnału B w początkowej fazie działania programu jest równa 0
- Czas próbkowania z jakim pobierane są zliczenia z enkodera równy 10 milisekund

W drugiej części kodu została zdefiniowana funkcja setup(), która jest wywoływana automatycznie po włączeniu zasilania. Jest ona wykorzystywana do ustawienia wartości początkowych zmiennych oraz deklaracji wejść i wyjść układu. Zawartość funkcji setup:

- Ustawienie trybu INPUT_PULL dla pinów. Jest to istotna zmiana w porównaniu do kodu z dokumentacji. Dzięki niej Arduino korzysta z wewnętrznie wbudowanych rezystorów podciągających, dzięki czemu nie ma potrzeby używania zewnętrznych rezystorów pull-up
- Otwarcie portu szeregowego i ustawienie prędkości na 9600 bodów (bity na sekundę)
- Funkcja attachInterrupt odpowiada za wywołanie funkcji interrupt podczas wykrycia na pinie A_PHASE rosnącej zmiany zbocza sygnału

W trzeciej części kodu została zdefiniowana funkcja loop(), która wywoływana jest w nieskończonej pętli. W funkcji tej, został zdefiniowany output programu. Dane wyjściowe zawierają:

- Informacje na temat zmiany kąta obrotu wału w stopniach. Jest to różnica wartości flag_A i flag_B
- Czas od rozpoczęcia pracy programu w milisekundach. Otrzymany z funkcji millis()

40

W czwartej części kodu została zdefiniowana funkcja interrupt(), której zadaniem jest inkrementacja wartości flag_A i flag_B w zależności od kierunku ruchu wału enkodera.

### 5.2. Schemat działania aplikacji

Aplikacja została napisana w języku Python. Został on wybrany ze względu na:

- Bardzo duży wybór bibliotek. Szczególnie przydatne biblioteki:
a) pySerial - umożliwia w prosty sposób wczytanie danych z Arduino do aplikacji
b) matplotlib – umożliwia w prosty sposób tworzenie wykresów z plików tekstowy. Dodatkowo klasa Animation pozwala na proste stworzenie wykresów animowanych, które zostały zaimplementowane w programie
c) tkinter – standardowa biblioteka do tworzenia GUI. Pozwala w prosty i szybki sposób stworzyć graficzny interfejs aplikacji
d) Scipy – zawiera proste funkcje do wygładzania powstałego wykresu
e) Pandas – biblioteka do manipulacji i analizy danych
- Bardzo duże wsparcie społeczności
- Prosta składnia języka programowania

Aplikacja składa się z:

- Dwóch głównych plików gui.py i metody.py
- Czterech plików tekstowych, do których zapisywane są wyniki obliczeń
- Jednego pliku z rozszerzeniem png, który dekoruje interfejs graficzny użytkownika

Plik metody.py zawiera definicje wszystkich funkcji używanych w programie. Plik gui.py odpowiada za wygląd aplikacji i tworzenie czterech animowanych wykresów w czasie rzeczywistym na podstawie odpowiednich plików tekstowych. Kod źródłowy zawarty w obu plikach został umieszczony w załączniku nr 3.

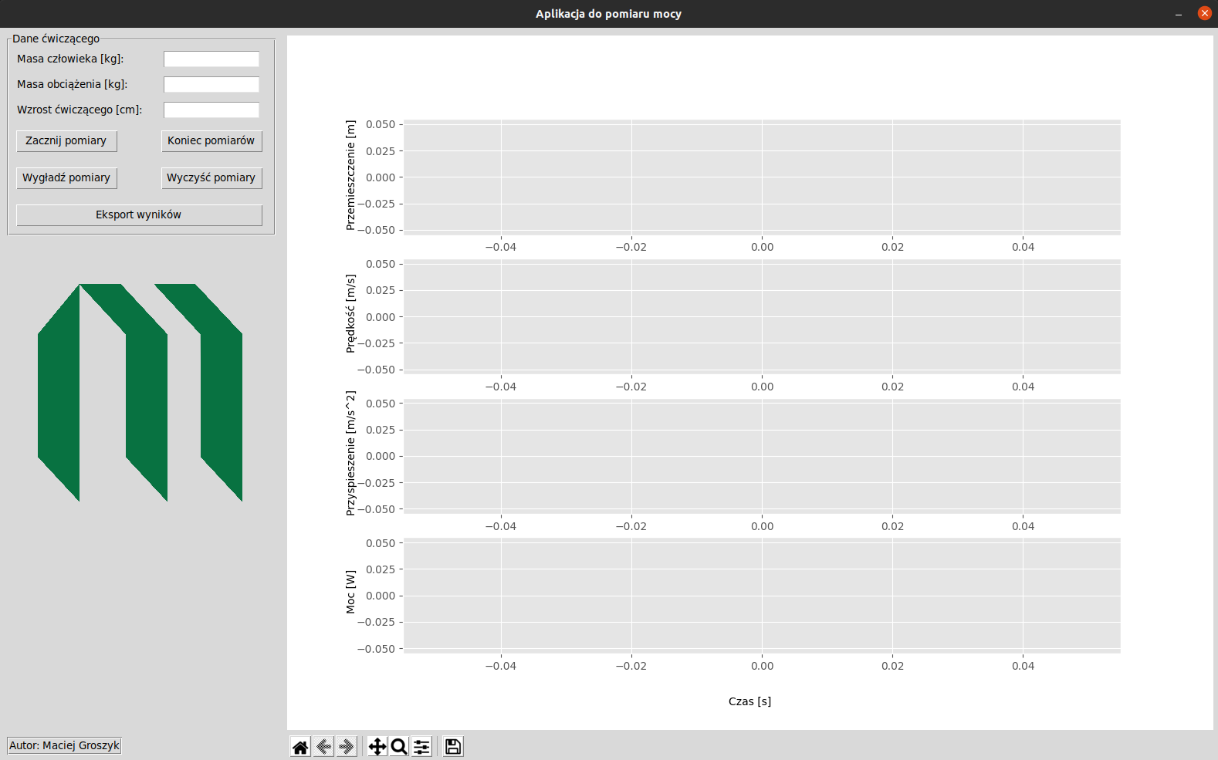
[picture p18: figure]

41

Interfejs graficzny aplikacji:

Rysunek 15: Interfejs graficzny aplikacji do pomiaru mocy

Interfejs graficzny został podzielony na dwa główne panele. Panel po lewej stronie zawiera miejsce na wpisanie przez użytkownika danych na temat ćwiczącego. Posiada również cztery funkcjonalne przyciski:

- Przycisk „Zacznij pomiary” jest odpowiedzialny za walidację wpisanych przez użytkownika wartości w pola tekstowe
- Przycisk „Koniec pomiarów” zatrzymuje proces zbierania danych z Arduino
- Przycisk „Wygładź pomiary” wygładza wszystkie cztery wykresy na prawym panelu
- Przycisk „Wyczyść pomiary” czyści wszystkie pliki tekstowe z zebranych pomiarów, co powoduje również usunięcie wykresów z interfejsu graficznego
- | Przycisk | „Eksport | wyników” | przesyła | informacje | dotyczące
maksymalnych wartości przemieszczenia, prędkości i mocy oraz średniej wartości prędkości

Panel z prawej strony zawiera cztery pola, na których zostaną zwizualizowane odpowiednie wykresy.

42

### 5.2.1. Opis działania programu

Po uruchomieniu programu do pomiaru mocy na ekranie komputera ukaże się interfejs graficzny przedstawiony na rysunku 13. Aby aplikacja mogła rozpocząć obliczanie oraz wizualizację danych pomiarowych należy wcisnąć przycisk „Zacznij pomiary”. Do przycisku tego jest przypisana główna funkcja programu o nazwie clicked(), która na początku sprawdza wprowadzone w pola tekstowe wartości. W zależności od ich poprawności tworzony jest odpowiedni wątek typu daemon. Dzięki niemu aplikacja może wykonywać kilka zadań na raz i nie ma problemu z używaniem w interfejsie graficznym przycisków podczas tworzenia wykresów. Następnie ustawiona została globalna zmienna o nazwie keepGoing. W zależności od jej wartości wykonywane są kolejne zadania programu. Jeśli zmienna keepGoing ma przypisaną wartość True zostaje wykonany cały proces poboru i obliczeń danych z Arduino. Jeśli natomiast zmienna ta ma przypisaną wartość False zostaje przerwana dostawa danych z Arduino.

Utworzony wcześniej wątek wykonuje funkcję readData() odpowiedzialną za zczytywanie wyników z enkodera, obliczenia i zapis do plików tekstowych uzyskanych wyników. Na początku funkcja ta sprawdza czy Arduino jest poprawnie połączone z komputerem. Następnie dane z Arduino są pobierane w postaci tablicy za pomocą biblioteki pySerial. Wartości z tablicy są konwertowane na radiany i przechodzą przez cykl obliczeń opisany w rozdziale 4. Gotowe wartości przemieszczenia, prędkości, przyspieszenia i mocy są zapisywane do plików tekstowych.

Głównym zadaniem aplikacji jest tworzenie wykresów w czasie rzeczywistym podczas wykonywania ćwiczenia. W tym celu do aplikacji wykorzystano bibliotekę matplotlib, natomiast odpowiedzialną funkcją za animacje jest FuncAnimation(). Metoda ta tworzy animacje, wielokrotnie wykonując funkcje animate(), która pobiera przeliczone wartości z plików tekstowych i na ich podstawie tworzy wykres. Po upłynięciu czasu odświeżania, który został ustawiony na 1 ms, narysowany wykres zostaje wyczyszczony, a na podstawie zaktualizowanego pliku tekstowego funkcja animate() ponownie rysuje wykres.

Po zakończeniu ćwiczenia należy zakończyć działanie wątku za pomocą przycisku „Zakończ pomiary”.

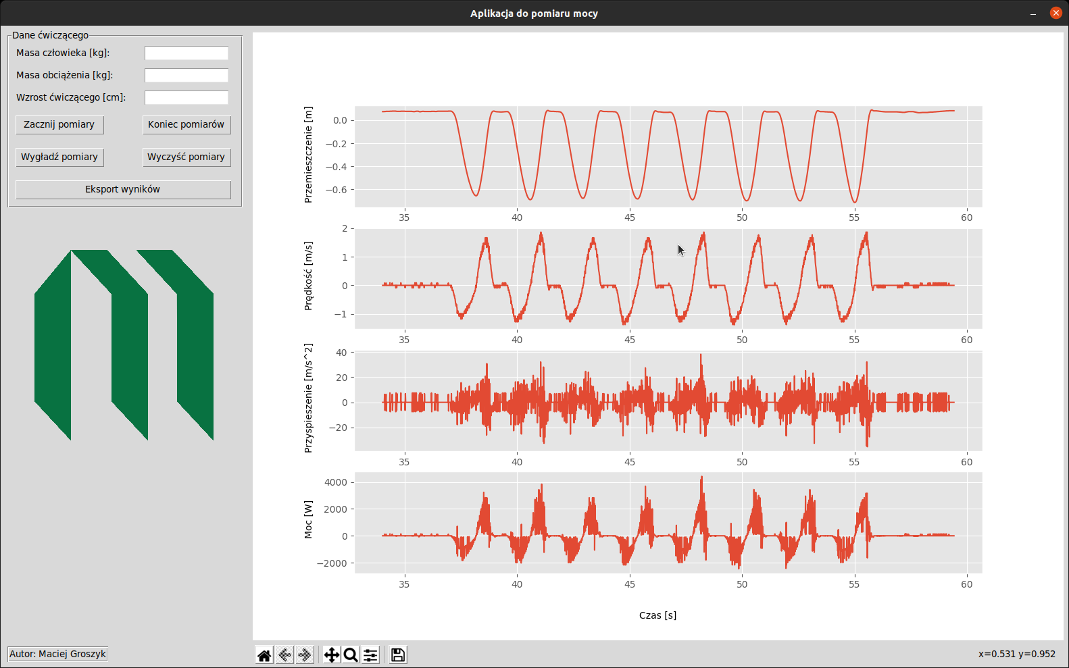
[picture p19: figure]

43

Rysunek 16: Wyniki pomiarów przed wygładzeniem

Otrzymane wykresy (rysunek 16) wymagają zastosowania funkcji wygładzającej smoothing() w celu uzyskania czytelnych wyników. Opiera się ona na funkcji savgol_filter() z biblioteki scipy. Jest to filtr cyfrowy Savitzky'ego – Golaya, który stosuje się do sygnału cyfrowych w celu wygładzania danych, w tym przypadku chodzi o niwelowanie wpływu szumu, który jest niewielki, ale jest bardzo wzmacniany przez różniczkowanie [19].

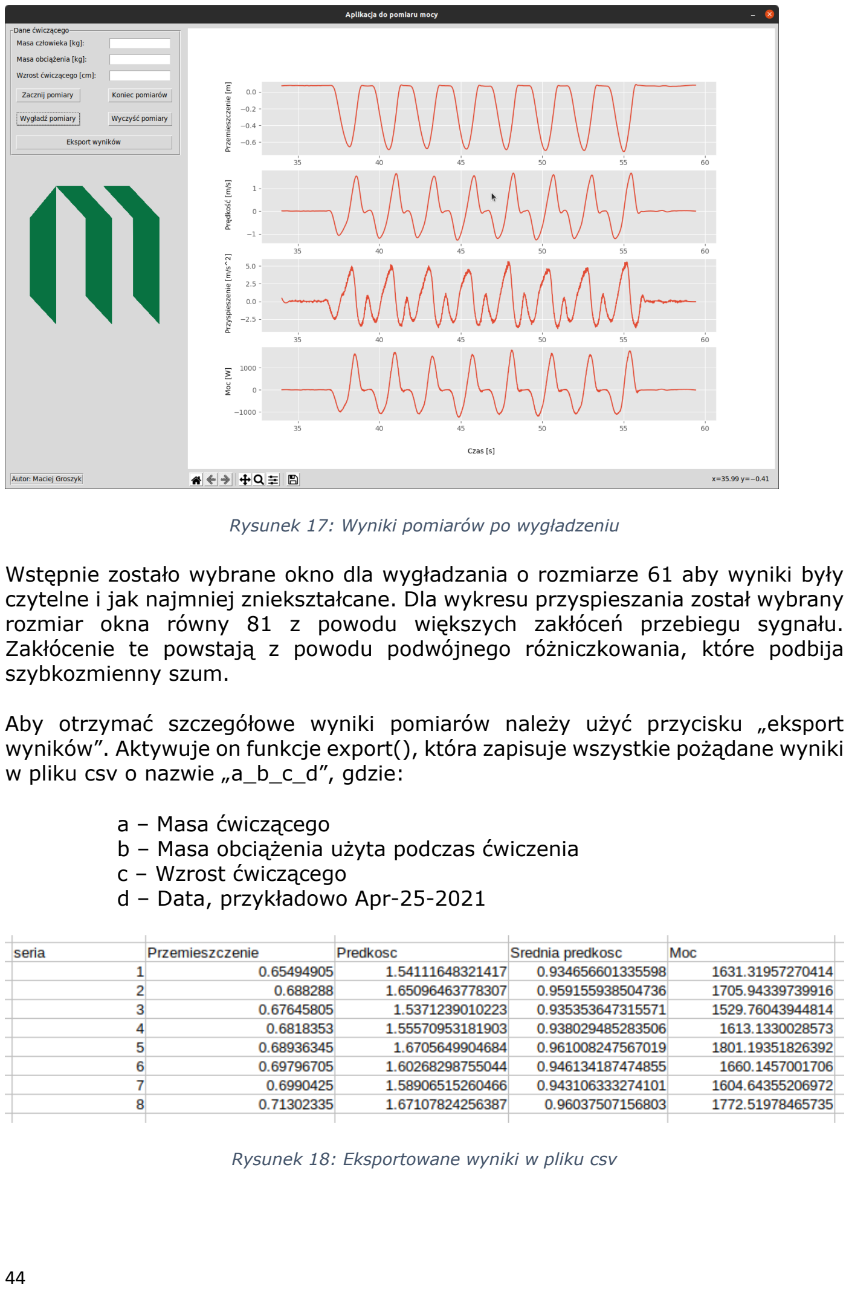
[picture p20: page 44]

44

Rysunek 17: Wyniki pomiarów po wygładzeniu

Wstępnie zostało wybrane okno dla wygładzania o rozmiarze 61 aby wyniki były czytelne i jak najmniej zniekształcane. Dla wykresu przyspieszania został wybrany rozmiar okna równy 81 z powodu większych zakłóceń przebiegu sygnału. Zakłócenie te powstają z powodu podwójnego różniczkowania, które podbija szybkozmienny szum.

Aby otrzymać szczegółowe wyniki pomiarów należy użyć przycisku „eksport wyników”. Aktywuje on funkcje export(), która zapisuje wszystkie pożądane wyniki w pliku csv o nazwie „a_b_c_d”, gdzie:

a – Masa ćwiczącego
b – Masa obciążenia użyta podczas ćwiczenia c – Wzrost ćwiczącego
d – Data, przykładowo Apr-25-2021

Rysunek 18: Eksportowane wyniki w pliku csv

45

Schemat blokowy działania algorytmu eksportowania danych:

Aby otrzymać, maksymalne wyniki z plików tekstowych należało poddać je wcześniejszej obróbce. W tym celu dane z plików tekstowych zostały zapisane w formacie ramki danych. Następnie została ona poddana normalizacji aby wyniki mieściły się w przedziale -1:1. Kolejno został użyty próg o wartości 0.8, dzięki któremu części wykresu zawierająca maksima w każdym powtórzeniu została oddzielona od reszty wartości. Wszystkim punktom z tych części wykresu zostały przypisane kolejno numery, które są związane z numerem powtórzenia podczas ćwiczenia. Następnie została użyta funkcja max() z biblioteki pandas, która znalazła największe wartości. Analogiczną metodą zostały znalezione średnie wartości prędkości. Zmniejszony został jedynie próg tak, aby brać pod uwagę wszystkie dodatnie wartości prędkości.

W przypadku obliczania maksymalnego przemieszczenia, wymagane było znalezienie najniższej wartości, która oznaczała głębokość przysiadu oraz występującej po minimum najwyższej wartości, która powstawała w wyniku dynamicznego wyprostu ćwiczącego. Za pomocą wyznaczonych lokalnych maksimów i minimów możemy obliczyć przemieszczenie podczas każdego z powtórzeń.

Przekształcenie pliku tekstowego do ramki danych

Znormalizowanie danych do przedziału <-1;1>

Ustawienie progu na konkretną wartość w zależności od sygnału, aby oddzielić część z lokalnym maksymum od reszty danych

Podział danych za pomocą przypisania, każdej wartości numeru odpowiadającemu za numer powtórzenia

46

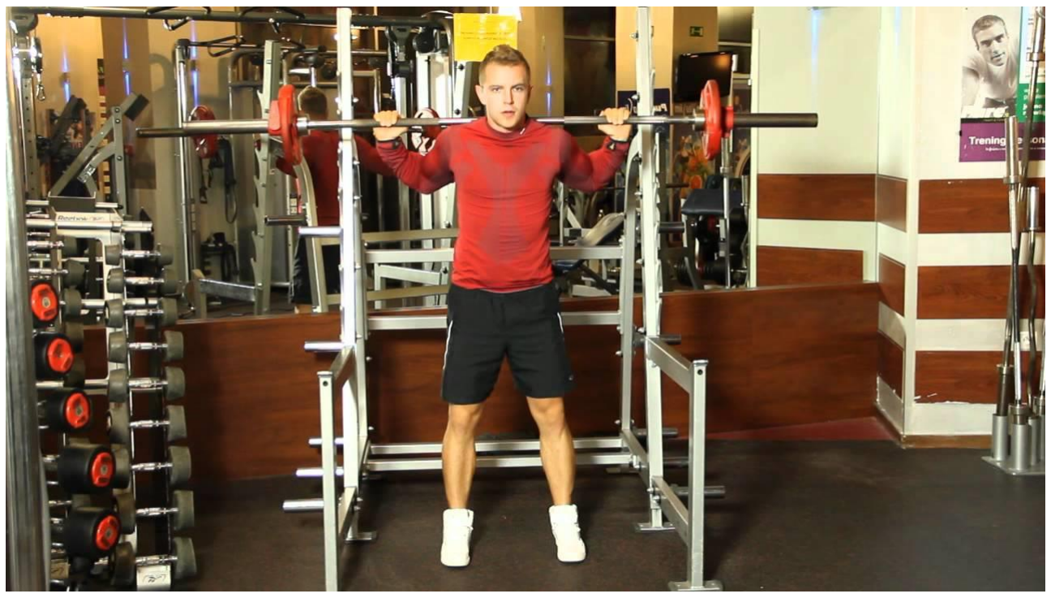
[picture p21: figure]

47

### 6. Sposób działania urządzenia

W celu uzyskania jak najdokładniejszych rezultatów zalecana jest obecność osoby, która będzie odpowiedzialna za korzystanie z aplikacji. Aby rozpocząć pomiar mocy za pomocą skonstruowanego urządzenia, najpierw należy zamieścić uchwyt zamocowany na końcu linki na sztandze. Miejsce zawieszenia uchwytu nie wpływa na uzyskane wyniki, dzięki czemu użytkownik urządzenia, może dobrać miejsce zawieszania tak aby linka nie przeszkadzała podczas przysiadu. Następnie należy podłączyć kabel USB zasilający płytkę Arduino do komputera w celu przekazywania informacji z enkodera. W dalszej kolejności wymagane jest uruchomienie aplikacji odpowiadającej za zapisanie, analizowanie, przetwarzanie i wizualizacje danych z enkodera oraz usunięcie poprzednich pomiarów. W przeznaczonych do tego miejscach w aplikacji należy podać parametry osoby wykonującej ćwiczenie, takie jak wzrost w centymetrach, masa ciała w kilogramach i obciążenie sztangi w kilogramach. Osoba wykonująca ćwiczenia ustawia się w pozycji początkowej do wykonania ćwiczenia przedstawionej na rysunku 17.

Rysunek 19: Pozycja początkowa do przysiadu [21]

Gdy użytkownik urządzenia jest gotowy do wykonania ćwiczenia, operator aplikacji zaczyna pomiary klikając przeznaczony do tego przycisk „Zacznij pomiary”. Następnie ćwiczący wykonuje dowolną liczbę powtórzeń. Po jej zakończeniu, operator aplikacji kończy pomiary, za pomocą przycisku „Koniec pomiarów”. Uzyskane wykresy obrazują niewygładzone odczyty z enkodera (rysunek 16), które należy wygładzić przyciskiem „Wygładź pomiary”. Aby otrzymać dokładne wartości z każdego powtórzenia należy eksportować wyniki przyciskiem „Eksportuj wyniki”, a następnie otworzyć nowo powstały plik csv w folderze z aplikacją.

48

49

## 7. Testy

### 7.1. Kalibracja

Przed przystąpieniem do testów została przeprowadzona kalibracja urządzenia. Przy pomocy miarki sprawdzona została prawdziwość odczytów enkodera. Na smyczy zostały zaznaczone punkty co 10 centymetrów. Następnie stopniowo wyciągano linkę i sprawdzano odczyt z enkodera.

Rysunek 20: Przebieg przemieszczenia podczas kalibracji

Następnie powstały plik tekstowy został przekonwertowany do ramki danych. Kolejno zastosowana została funkcja value_counts() z biblioteki pandas, aby uzyskać informacje, ile razy dana wartość przemieszczenia się powtórzyła w przebiegu funkcji.

Przemieszczenie nominalne [cm] | Odczyt z enkodera [cm] | ilość odczytów
40 | 39,84 | 1598
30 | 29,73 | 1366
30 | 29,54 | 1092
10 | 10,11 | 899
20 | 19,92 | 810
10 | 10,3 | 302
20 | 20,02 | 291
30 | 29,44 | 287
0 | 0 | 253

Tabela 3: Wyniki pomiaru kalibracyjnego

Wyniki z rysunku 21 pokrywają się z rezultatami na wykresie, a także odpowiadają pomiarom za pomocą miarki. Małe błędy wynikają z niedokładności pomiarowca, oraz położenia punktu zero, który znajduję się w środku prowadnika linki.

50

### 7.2. Porównanie wyników z urządzeniem komercyjnym firmy MuscleLab

MuscleLab jest to urządzenie norweskiej firmy Ergotest Innovation AS, służące do pomiaru mocy podczas przysiadu z obciążeniem. Urządzenie to jest oparte na enkoderze obrotowym o rozdzielczości 0.019 mm i czasie próbkowania równym 5 ms. Nieznane są jednak algorytmy obliczeniowe zastosowane w oprogramowaniu aplikacji.

Dzięki pomocy pana Michała Ficonia, zostało udostępnione urządzenie MuscleLab do wykonania pomiarów porównawczych. Doktor Szymon Cygan wykonał po 8 przysiadów przy różnych obciążeniach na sztandze. Ruch był jednocześnie monitorowany przez MuscleLab, urządzenie opisywane w tej pracy, oraz kamerę z której wideo trafiło do programu wyznaczania mocy na podstawie filmu (praca dyplomowa inżynierska Julii Król). Pierwsze pomiary dość znacząco różniły się od wyników z MuscleLab, było to spowodowane dobraniem zbyt dużego okna wygładzania. W związku z tym zmieniłem pierwotne parametry wygładzania, na 11 dla pomiarów prędkości, 41 dla wyników mocy i niezmiennie 61 dla wartości przyspieszenia. Rezultaty pomiarów zostały zaprezentowane w tabeli 3 i 4.

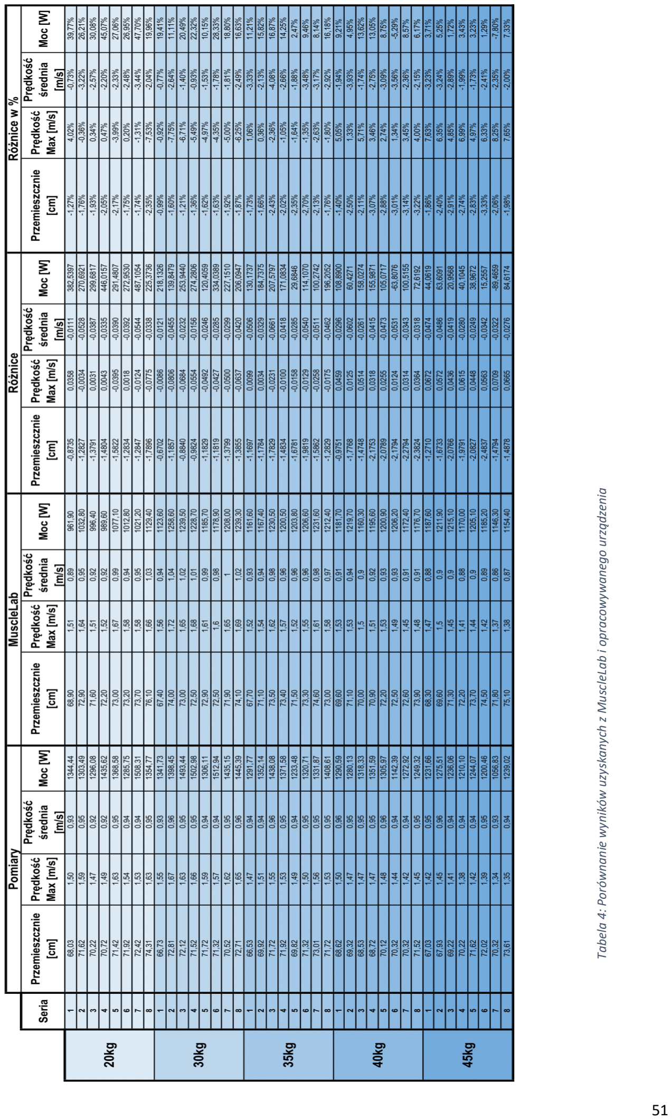
[picture p22: page 51]

51

Tabela 4: Porównanie wyników uzyskanych z MuscleLab i opracowywanego urządzenia

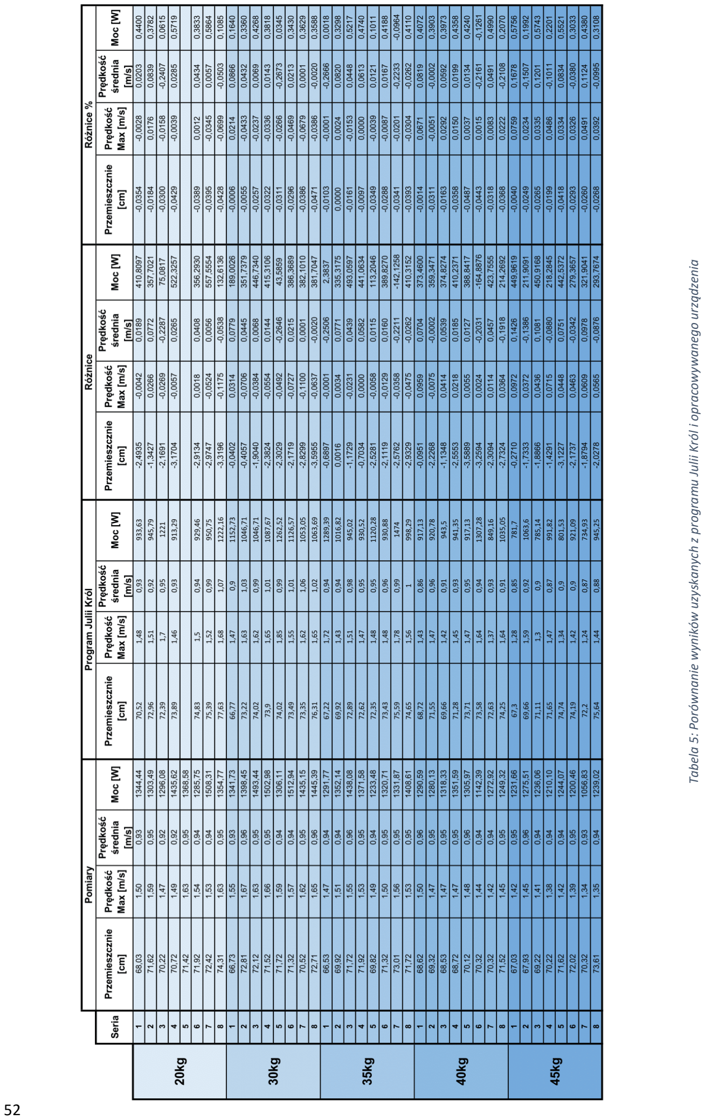
[picture p23: page 52]

52

Tabela 5: Porównanie wyników uzyskanych z programu Julii Król i opracowywanego urządzenia

53

Największe rozbieżności pojawiły się w wynikach obliczeń mocy. Jest to spowodowane nieznajomością procesu obliczeniowego w urządzeniu MuscleLab. Kolejnym czynnikiem, który mógł powodować różnice w wynikach jest wygładzanie sygnału, które mogło nieprawidłowo wygładzić maksymalne wyniki. Małe różnice w przemieszczeniu mogą być spowodowane gwałtownymi ruchami, przez które koło nie nadążało nad ruchem linki.

54

55

### 8. Uwagi końcowe

Wszystkie założenia projektu stawiane przed wykonaniem pracy zostały zrealizowane. Urządzenie jest tanie i proste w obsłudze.

### 8.1. Ocena realizacji urządzenia

Z powodu małego budżetu i ograniczonego czasu realizacji projektu, konieczne było zastosowanie nieeleganckich rozwiązań podczas konstrukcji urządzenia takich jak smycz. Dużo lepszym rozwiązaniem byłoby zastosowanie autorskiego urządzenia opartego na przykład na sprężynie napędowej. Pozwoliłoby to na ograniczenie problemu zrywu.

Materiały zastosowane do wytworzenia obudowy są tanie i łatwe w obróbce natomiast dość nie trwałe. Dodatkowo nie zostało zintegrowane Arduino z urządzeniem, przez co jest narażane na uszkodzenia podczas ćwiczeń. Koło zamachowe wykonane ze złączonej sklejki, nie jest dobrym rozwiązaniem, ponieważ może się ono pod wpływem użytkowania i czasu rozkleić.

Przy większym budżecie, można by się zastanowić nad użyciem enkodera z wyższą rozdzielczością, co pozwoliłoby na zmniejszenie wymaganej wielkości koła zamachowego, a co za tym idzie na zmniejszenie wielkości całego urządzenia.

### 8.2. Ocena realizacji aplikacji

Aplikacja napisana w Pythonie spełniła początkowe założenia. W czasie rzeczywistym realizuje wszelkie obliczenia i wizualizuje otrzymane wyniki. Zmiana, która poprawiłaby funkcjonalność programu, to usunięcie przycisku „Wygładź pomiary” i wykonywanie wygładzania wykresu w czasie rzeczywistym. Niestety podczas prób implementacji takiego rozwiązania, aplikacja traciła na wydajności, a wykresy tworzyły się z dużym opóźnieniem. Kolejnym dobrym pomysłem byłoby przeprowadzenie większej ilości testów z urządzeniem komercyjnym, aby lepiej dobrać parametry wygładzania przebiegu funkcji.

W czasie użytkowania aplikacji, został znaleziony jeden problem, który znacząco utrudnia pomiary. Podczas początkowych pomiarów, zdarza się, że pojawia się przypadkowy pik, który przez swoje duże wartości przeskalowuje wykresy w ten sposób, że reszta wyników jest nie czytelna. W tym przypadku należy podczas rysowania wykresów, wyczyścić pliki tekstowe przyciskiem „Wyczyść pomiary” i następnie kontynuować ćwiczenie.

W dzisiejszych czasach dużą wagę przykłada się do wyglądu i designu aplikacji. Głównie na tej podstawie konsumenci wybierają produkt, który chcą zakupić.
Natomiast | interfejs graficzny | w | aplikacji | został wykonany za | pomocą

56

podstawowych bibliotek Pythona, przez co wyglądem przypomina programy z lat
90. Program powinno się zmienić na klimat sportowy aby bardziej przyciągał uwagę. Kolejną zmianą programu do użytku powszechnego, byłoby ukrycie wartości mocy uzyskiwanych podczas schodzenia w dół w czasie przysiadu. Ruch z obciążeniem w dół powinien być wolny, dokładny. Wyświetlanie mocy, może motywować sportowca do jak najszybszych ruchów, co może skutkować poważną kontuzją.

57

### 9. Bibliografia

[1] https://shop.gymaware.com/?target=international [Online]
[2] http://www.przeglad.amp.edu.pl/uploads/2017/1/132_1_50_2017.pdf [Online]
[3] https://www.polityka.pl/tygodnikpolityka/ludzieistyle/1560349,1,komputery-odmienily-szachy.read#:~:text=Wbrew%20obawom%20komputery%20nie%20zabi%C5%82y,Ale%20ca%C5%82kowicie%20je%20odmieni%C5%82y.&text=ze%20stwor zonym%20przez%20IBM%20superkomputerem,czas%C3%B3w%20przegra%C5 %82%20jedn%C4%85%20z%20partii. (https://www.polityka.pl/tygodnikpolityka/ludzieistyle/1560349,1,komputery-odmienily-szachy.read) [Online]
[4] https://mcourt.eu/maszyna-do-wyrzucania-pilek-tenisowych-lobster-phenom-ii-p-418.html (https://mcourt.eu/maszyna-do-wyrzucania-pilek-tenisowych-lobster-phenom-ii-p-418.html) [Online]
[5] https://wformie24.poradnikzdrowie.pl/cwiczenia/nogi/trening-miesni-nog-cwiczenia-w-domu-i-na-silowni-aa-xJGw-HXBP-y8Ba.html (https://wformie24.poradnikzdrowie.pl/cwiczenia/nogi/trening-miesni-nog-cwiczenia-w-domu-i-na-silowni-aa-xJGw-HXBP-y8Ba.html) [Online]
[6] https://poradniksportowy.pl/cwiczenie/przysiady-ze-sztang-na-karku/[Online]
[7] https://www.maskblogspot.com/best-back-muscle-building-workout-and-exercises-in-gym/ (https://www.maskblogspot.com/best-back-muscle-building-workout-and-exercises-in-gym/) [Online]
[8] https://gymaware.com/products/ [Online]
[9] http://fitronic.sk/en/project/fitro-dyne/ [Online]
[10] “Validation of an optical encoder during weight resistance movements and analysis of bench press sticking point power during fatigue” Eric Drinkwater,Brook Galna, Michael J Mckenna, David B Pyne, Patrick H Hunt
[11] “Understanding Position Transducer Technology for Strength and Conditioning Practitioners” Nigel Kent Harris, John Cronin, Krystie-Lee Taylor, Boris Jidovtseff, Jeremy M Sheppard
[12] https://pl.wikipedia.org/wiki/Enkoder [Online]
[13] https://www.ebmia.pl/wiedza/porady/automatyka-porady/enkoder/ [Online]
[14] http://automatyka4u2.pl/tag/linial-magnetyczny/ [Online]
[15] https://botland.com.pl/enkodery/9381-czujnik-obrotu-impulsator-enkoder-optyczny-dfrobot-400p-r.html (https://botland.com.pl/enkodery/9381-czujnik-obrotu-impulsator-enkoder-optyczny-dfrobot-400p-r.html) [Online]
[16] http://mobolab.org.pl/zestaw_arduino_co_znajduje_sie_w_pudelku/[Online]
[17] https://www.maxizoo.pl/p/flexi-new-classic-linka-rowy-s-3-m-1207921/[Online]
[18] https://wiki.dfrobot.com/Incremental_Photoelectric_Rotary_Encoder_-_400P_R_SKU__SEN0230 (https://wiki.dfrobot.com/Incremental_Photoelectric_Rotary_Encoder_-_400P_R_SKU__SEN0230) [Online]
[19] https://jansloniewicz.pl/wp-content/uploads/2015/12/back-squat.jpg [Online]
[20] Tadeusz Bober, Jerzy Zawadzki, „Biomechanika układu ruchu człowieka”, Wydawnictwo BK, Wrocław 2006, str. 140-150 [Książka]
[21] https://en.wikipedia.org/wiki/Savitzky%E2%80%93Golay_filter [Online]
[22] https://fitnow.pl/cwiczenia/przysiad-ze-sztanga-na-barkach-2/ [Online]

58

### 10. Spis załączników

1. Kod źródłowy aplikacji w Arduino
2. Kod źródłowy aplikacji w Pythonie
3. Rysunek techniczny projektu

### 11. Spis rysunków

Rysunek 12: Schemat połączenia enkodera z mikrokontrolerem z dokumentacji

59

Rysunek 19: Pozycja początkowa do przysiadu [21] | 47
Rysunek 20: Przebieg przemieszczenia podczas kalibracji | 49

### 12. Spis tabel

Tabela 1: Równania regresji do wyznaczania ciężarów części ciała człowieka
według V. N. Zatziorsky’ego [19] | 35

Tabela 2: Promienie wodzące (r) środków ciężkości ciała w % ich długości
(mierzy się zawsze od bliższego końca) [20] | 35
Tabela 3: Wyniki pomiaru kalibracyjnego | 49

Tabela 4: Porównanie wyników uzyskanych z MuscleLab i opracowywanego
urządzenia | 51 (https://d.docs.live.net/6db6f1eca20b7d4f/Pulpit/praca%20inżynierska%20-%20finale.docx#_Toc70635002)

Tabela 5: Porównanie wyników uzyskanych z programu Julii Król i
opracowywanego urządzenia | 52 (https://d.docs.live.net/6db6f1eca20b7d4f/Pulpit/praca%20inżynierska%20-%20finale.docx#_Toc70635003)
